synthetic65535/CMeter/readme.md

# CMeter
Измеритель тока фрикции.

* Используемый микроконтроллер: atmega8
* Среда разработки: KiCad
* Прошивка для микроконтроллера: [Здесь](https://github.com/synthetic65535/CMeterFirmware)
