synthetic65535/CMeter/CMeterBase.kicad_pcb

## KiCad design CMeterBase.kicad_pcb (2019-01-22)

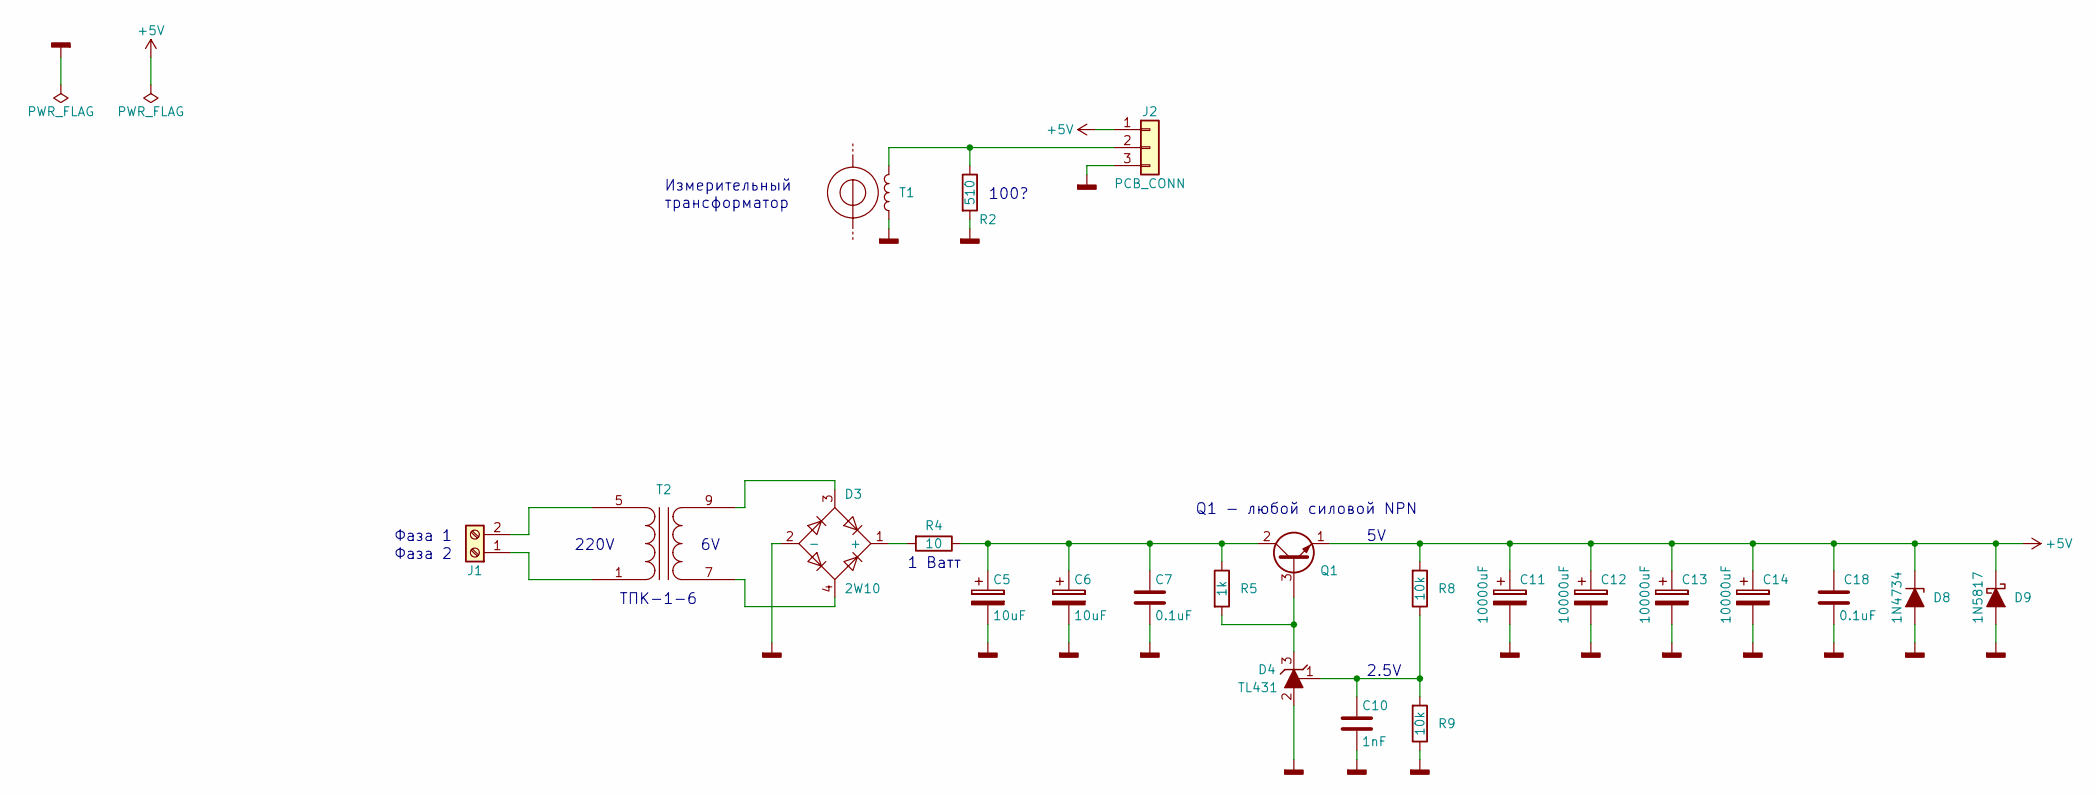
[picture p1: schematic CMeterBase.sch]

Parts:
C5, C6: 10uF; CP_Radial_D5.0mm_P2.00mm
C7, C18: 0.1uF; CAP
C10: 1nF; CAP
C11: 10000uF; CAP_D16_L36
C12, C13, C14: 10000uF; CAP_D16_L36-2
D3: 2W10; WOB_Bridge_Rectifier
D4: TL431
D8: 1N4734; DO-41
D9: 1N5817; DO-41
J1: Screw_Terminal_01x02; KLS2-306V-5.00-02P-2S
J2: PCB_CONN; Pin_Header_Straight_1x03_Pitch2.54mm
Q1: Q_NPN_ECB; TO-126_Horizontal
R2: 510; RES
R4: 10; RES1W
R5: 1k; RES
R8, R9: 10k; RES
T1: L_Measure; AC-1005_ZMCT102
T2: TPK-2-6; TPK-1

Connections:
+5V: C11.1, C12.1, C13.1, C14.1, C18.1, D8.1 (K), D9.1 (K), J2.1, Q1.1 (E), R8.2
GNDD: C5.2, C6.2, C7.2, C10.2, C11.2, C12.2, C13.2, C14.2, C18.2, D3.2 (-), D4.2 (A), D8.2 (A), D9.2 (A), J2.3, R2.2, R9.1, T1.1
unnamed: C5.1, C6.1, C7.1, Q1.2 (C), R4.1, R5.1
unnamed: C10.1, D4.1 (REF), R8.1, R9.2
unnamed: D3.1 (+), R4.2
unnamed: D3.3, T2.9 (SA)
unnamed: D3.4, T2.7 (SB)
unnamed: D4.3 (K), Q1.3 (B), R5.2
unnamed: J1.1, T2.1 (AA)
unnamed: J1.2, T2.5 (AB)
unnamed: J2.2, R2.1, T1.2

Notes on the sheet:
Фаза 2
Фаза 1
Измерительный трансформатор
220V
1 Ватт
2.5V
Q1 - любой силовой NPN
100?
ТПК-1-6

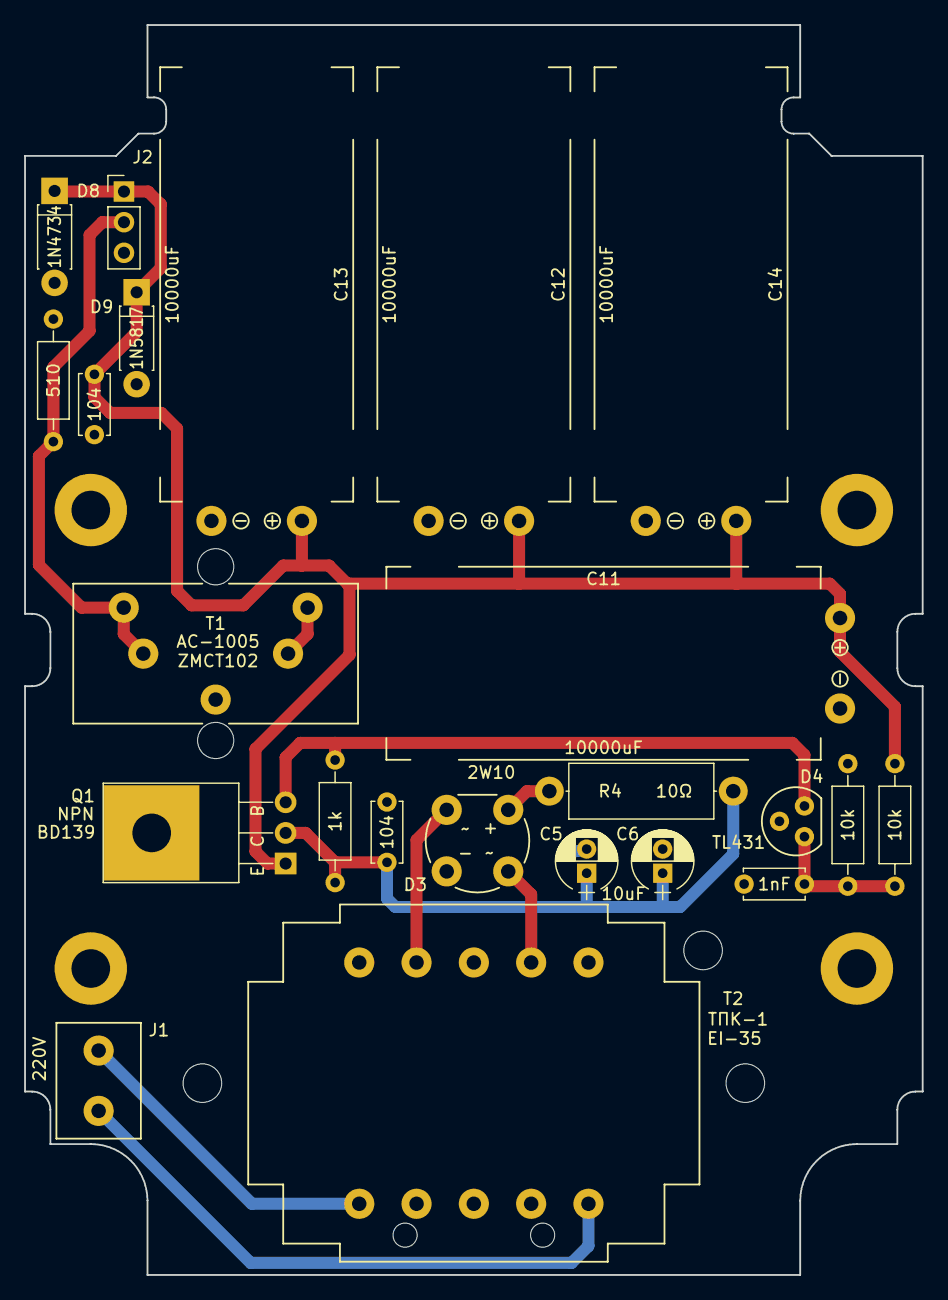
[picture p2: board CMeterBase.kicad_pcb from above]

Board: 2 copper layers, 74.4 x 103.6 mm, 24 parts (0 on the bottom side), 11 nets.

Other parts of the board:
CASE: Case_G1202_Base; Case_G1202_Base-2
