synthetic65535/CMeter/CMeterFront.kicad_pcb

## KiCad design CMeterFront.kicad_pcb (2019-01-20)

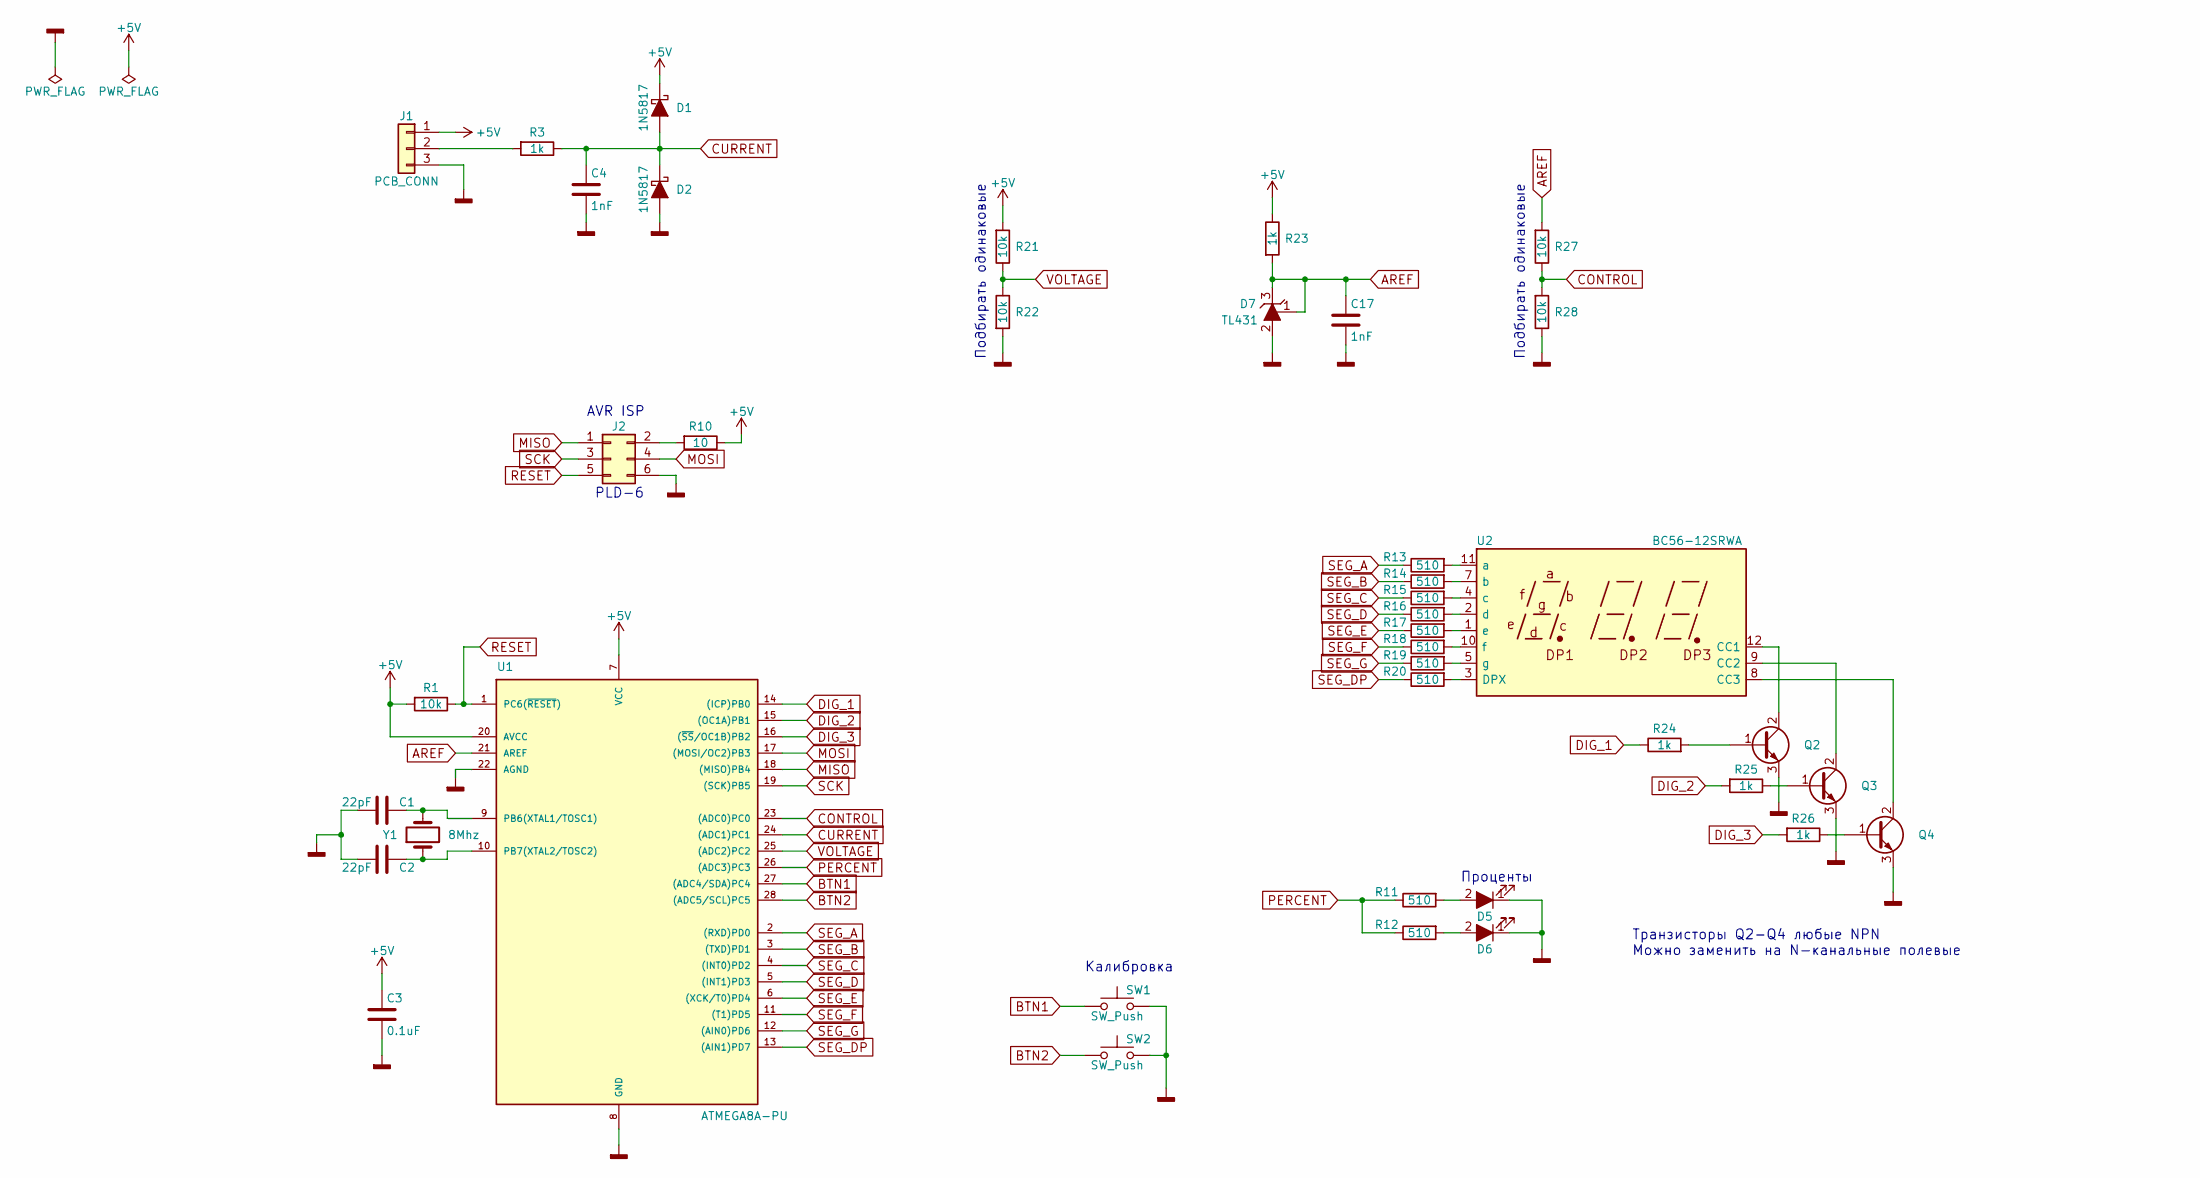
[picture p3: schematic CMeterFront.sch]

Parts:
C1, C2: 22pF; CAP
C3: 0.1uF; CAP
C4, C17: 1nF; CAP
D1, D2: 1N5817; DO-41
D5, D6: LED_ALT; LED_D5.0mm
D7: TL431
J1: PCB_CONN; Pin_Header_Straight_1x03_Pitch2.54mm
J2: PLD-6; AVR_ISP
Q2, Q3, Q4: Q_NPN_BCE; Q_BCE
R1, R21, R22, R27, R28: 10k; RES
R3, R23, R24, R25, R26: 1k; RES
R10: 10; RES
R11, R12, R13, R14, R15, R16, R17, R18, R19, R20: 510; RES
SW1, SW2: SW_Push; SW_PUSH_6mm_h5mm
U1: ATMEGA8A-PU; TRS-28_Connfly
U2: BC56-12SRWA; BC56-12SRWA-2
Y1: 8Mhz; Crystal_HC49-4H_Vertical

Connections:
+5V: C3.1, D1.1 (K), J1.1, R1.2, R10.1, R21.2, R23.1, U1.7 (VCC), U1.20 (AVCC)
AREF: C17.1, D7.1 (REF), D7.3 (K), R23.2, R27.2, U1.21 (AREF)
BTN1: SW1.1, U1.27 ((ADC4/SDA)PC4)
BTN2: SW2.1, U1.28 ((ADC5/SCL)PC5)
CONTROL: R27.1, R28.2, U1.23 ((ADC0)PC0)
CURRENT: C4.1, D1.2 (A), D2.1 (K), R3.1, U1.24 ((ADC1)PC1)
DIG_1: R24.1, U1.14 ((ICP)PB0)
DIG_2: R25.2, U1.15 ((OC1A)PB1)
DIG_3: R26.2, U1.16 ((~SS~/OC1B)PB2)
GNDD: C1.2, C2.2, C3.2, C4.2, C17.2, D2.2 (A), D5.1 (K), D6.1 (K), D7.2 (A), J1.3, J2.6, Q2.3 (E), Q3.3 (E), Q4.3 (E), R22.2, R28.1, SW1.2, SW2.2, U1.8 (GND), U1.22 (AGND)
MISO: J2.1, U1.18 ((MISO)PB4)
MOSI: J2.4, U1.17 ((MOSI/OC2)PB3)
unnamed: C1.1, U1.9 (PB6(XTAL1/TOSC1)), Y1.2
unnamed: C2.1, U1.10 (PB7(XTAL2/TOSC2)), Y1.1
unnamed: D5.2 (A), R11.2
unnamed: D6.2 (A), R12.2
unnamed: J1.2, R3.2
unnamed: J2.2, R10.2
unnamed: Q2.1 (B), R24.2
unnamed: Q2.2 (C), U2.12 (CC1)
unnamed: Q3.1 (B), R25.1
unnamed: Q3.2 (C), U2.9 (CC2)
unnamed: Q4.1 (B), R26.1
unnamed: Q4.2 (C), U2.8 (CC3)
unnamed: R13.2, U2.11 (a)
unnamed: R14.2, U2.7 (b)
unnamed: R15.2, U2.4 (c)
unnamed: R16.2, U2.2 (d)
unnamed: R17.2, U2.1 (e)
unnamed: R18.2, U2.10 (f)
unnamed: R19.2, U2.5 (g)
unnamed: R20.2, U2.3 (DPX)
PERCENT: R11.1, R12.1, U1.26 ((ADC3)PC3)
RESET: J2.5, R1.1, U1.1 (PC6(~RESET~))
SCK: J2.3, U1.19 ((SCK)PB5)
SEG_A: R13.1, U1.2 ((RXD)PD0)
SEG_B: R14.1, U1.3 ((TXD)PD1)
SEG_C: R15.1, U1.4 ((INT0)PD2)
SEG_D: R16.1, U1.5 ((INT1)PD3)
SEG_DP: R20.1, U1.13 ((AIN1)PD7)
SEG_E: R17.1, U1.6 ((XCK/T0)PD4)
SEG_F: R18.1, U1.11 ((T1)PD5)
SEG_G: R19.1, U1.12 ((AIN0)PD6)
VOLTAGE: R21.1, R22.1, U1.25 ((ADC2)PC2)

Notes on the sheet:
PLD-6
AVR ISP
Проценты
Транзисторы Q2-Q4 любые NPN Можно заменить на N-канальные полевые
Подбирать одинаковые
Калибровка

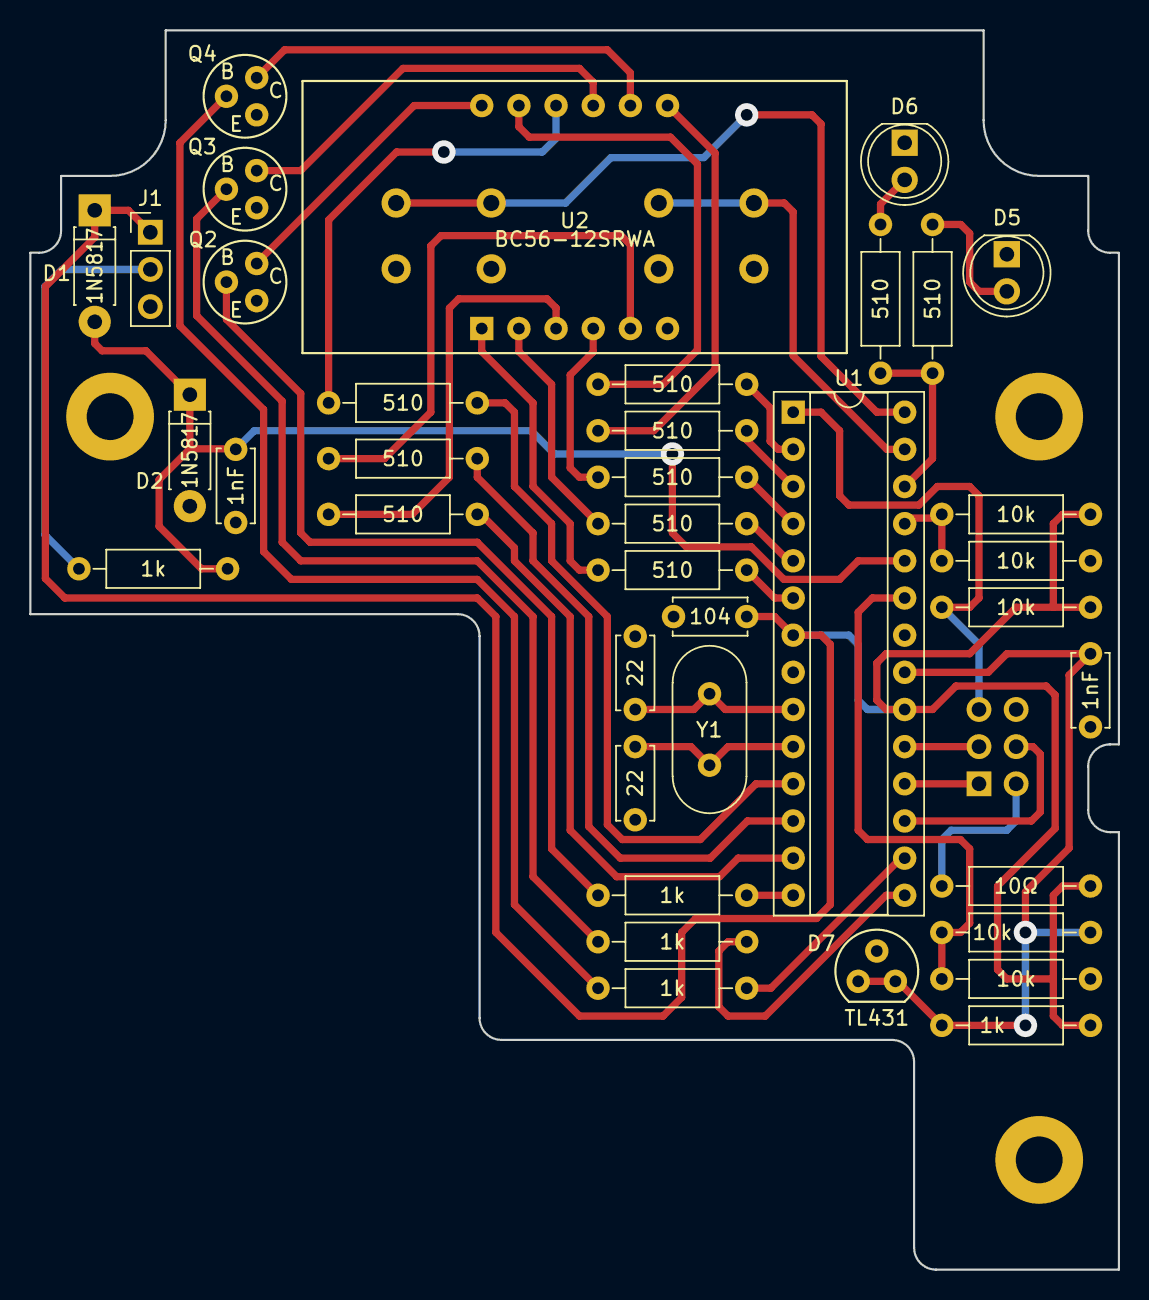
[picture p4: board CMeterFront.kicad_pcb from above]

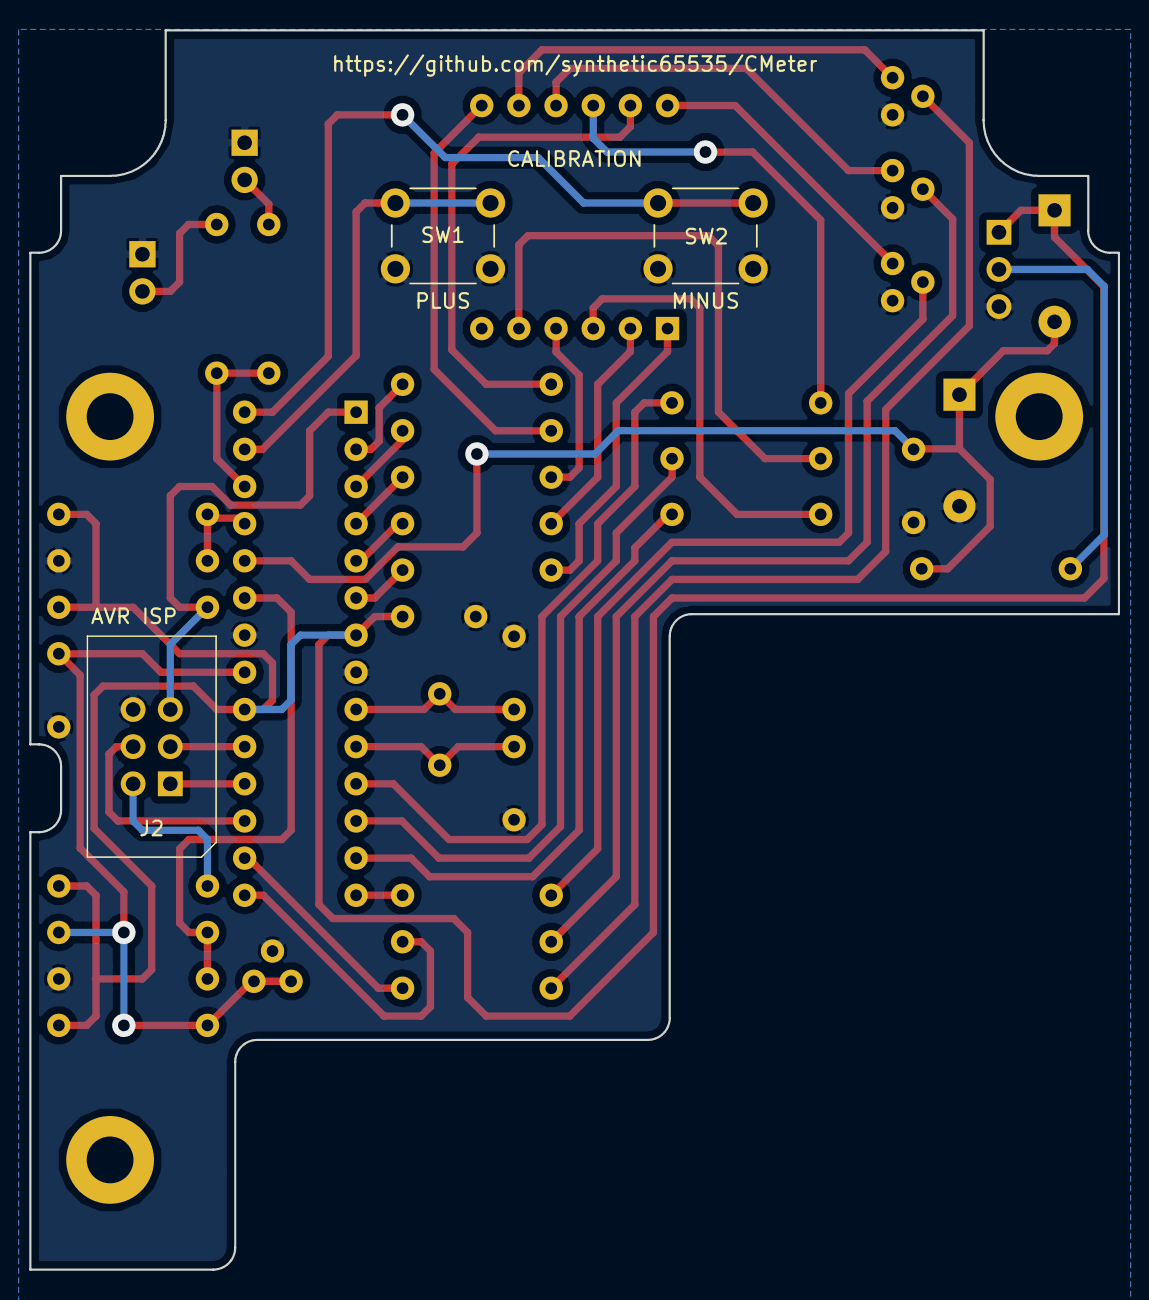
[picture p5: board CMeterFront.kicad_pcb from below]

Board: 2 copper layers, 74.4 x 84.7 mm, 43 parts (3 on the bottom side), 44 nets.

Other parts of the board:
CASE: Case_G1202_Front-2
T1: L_Measure; AC-1005_ZMCT102_Enclosure
